fablackner/keysatron/assembly/keysatron_bom.csv

Comment | Designator | Footprint | LCSC
100n | C1 | Capacitor_SMD:C_0603_1608Metric | C14663
2u2 | C11,C12 | Capacitor_SMD:C_0603_1608Metric | C23630
12p | C13,C14 | Capacitor_SMD:C_0402_1005Metric | C1547
4u7 | C2 | Capacitor_SMD:C_1206_3216Metric | C29823
33p | C3 | Capacitor_SMD:C_0603_1608Metric | C1663
10u | C4 | Capacitor_SMD:C_1206_3216Metric | C13585
4u7 | C5 | Capacitor_SMD:C_0603_1608Metric | C19666
100n | C6,C7,C8,C9,C10 | Capacitor_SMD:C_0402_1005Metric | C1525
RED | D1 | Diode_SMD:D_0603_1608Metric | C2286
B5819W | D2 | Diode_SMD:D_SOD-123 | C8598
GREEN | D3 | Diode_SMD:D_0603_1608Metric | C72043
SWD | J1 | Connector_PinHeader_2.54mm:PinHeader_1x05_P2.54mm_Vertical
USB | J2,J3 | Connector_USB:USB_A_Molex_67643_Horizontal
2.2u | L1 | Inductor_SMD:L_Sunlord_MWSA0518_5.4x5.2mm | C408408
100k | R1 | Resistor_SMD:R_0603_1608Metric | C25803
120k | R2 | Resistor_SMD:R_0603_1608Metric | C25808
68k | R3 | Resistor_SMD:R_0603_1608Metric | C23231
39k | R4 | Resistor_SMD:R_0603_1608Metric | C23153
1k | R5,R6 | Resistor_SMD:R_0603_1608Metric | C21190
47 | R7 | Resistor_SMD:R_0402_1005Metric | C25118
MP2451DT-LF-Z | U1 | Package_TO_SOT_SMD:SOT-23-6 | C14123
SRV05-4 | U2 | Package_TO_SOT_SMD:SOT-23-6 | C85364
STM32F405RGT6 | U3 | Package_QFP:LQFP-64_10x10mm_P0.5mm | C15742
16Mhz | Y1 | Crystal:Crystal_SMD_3225-4Pin_3.2x2.5mm | C13738
