fablackner/keysatron/keysatron.kicad_pcb

## KiCad design keysatron.kicad_pcb (2026-10-28)

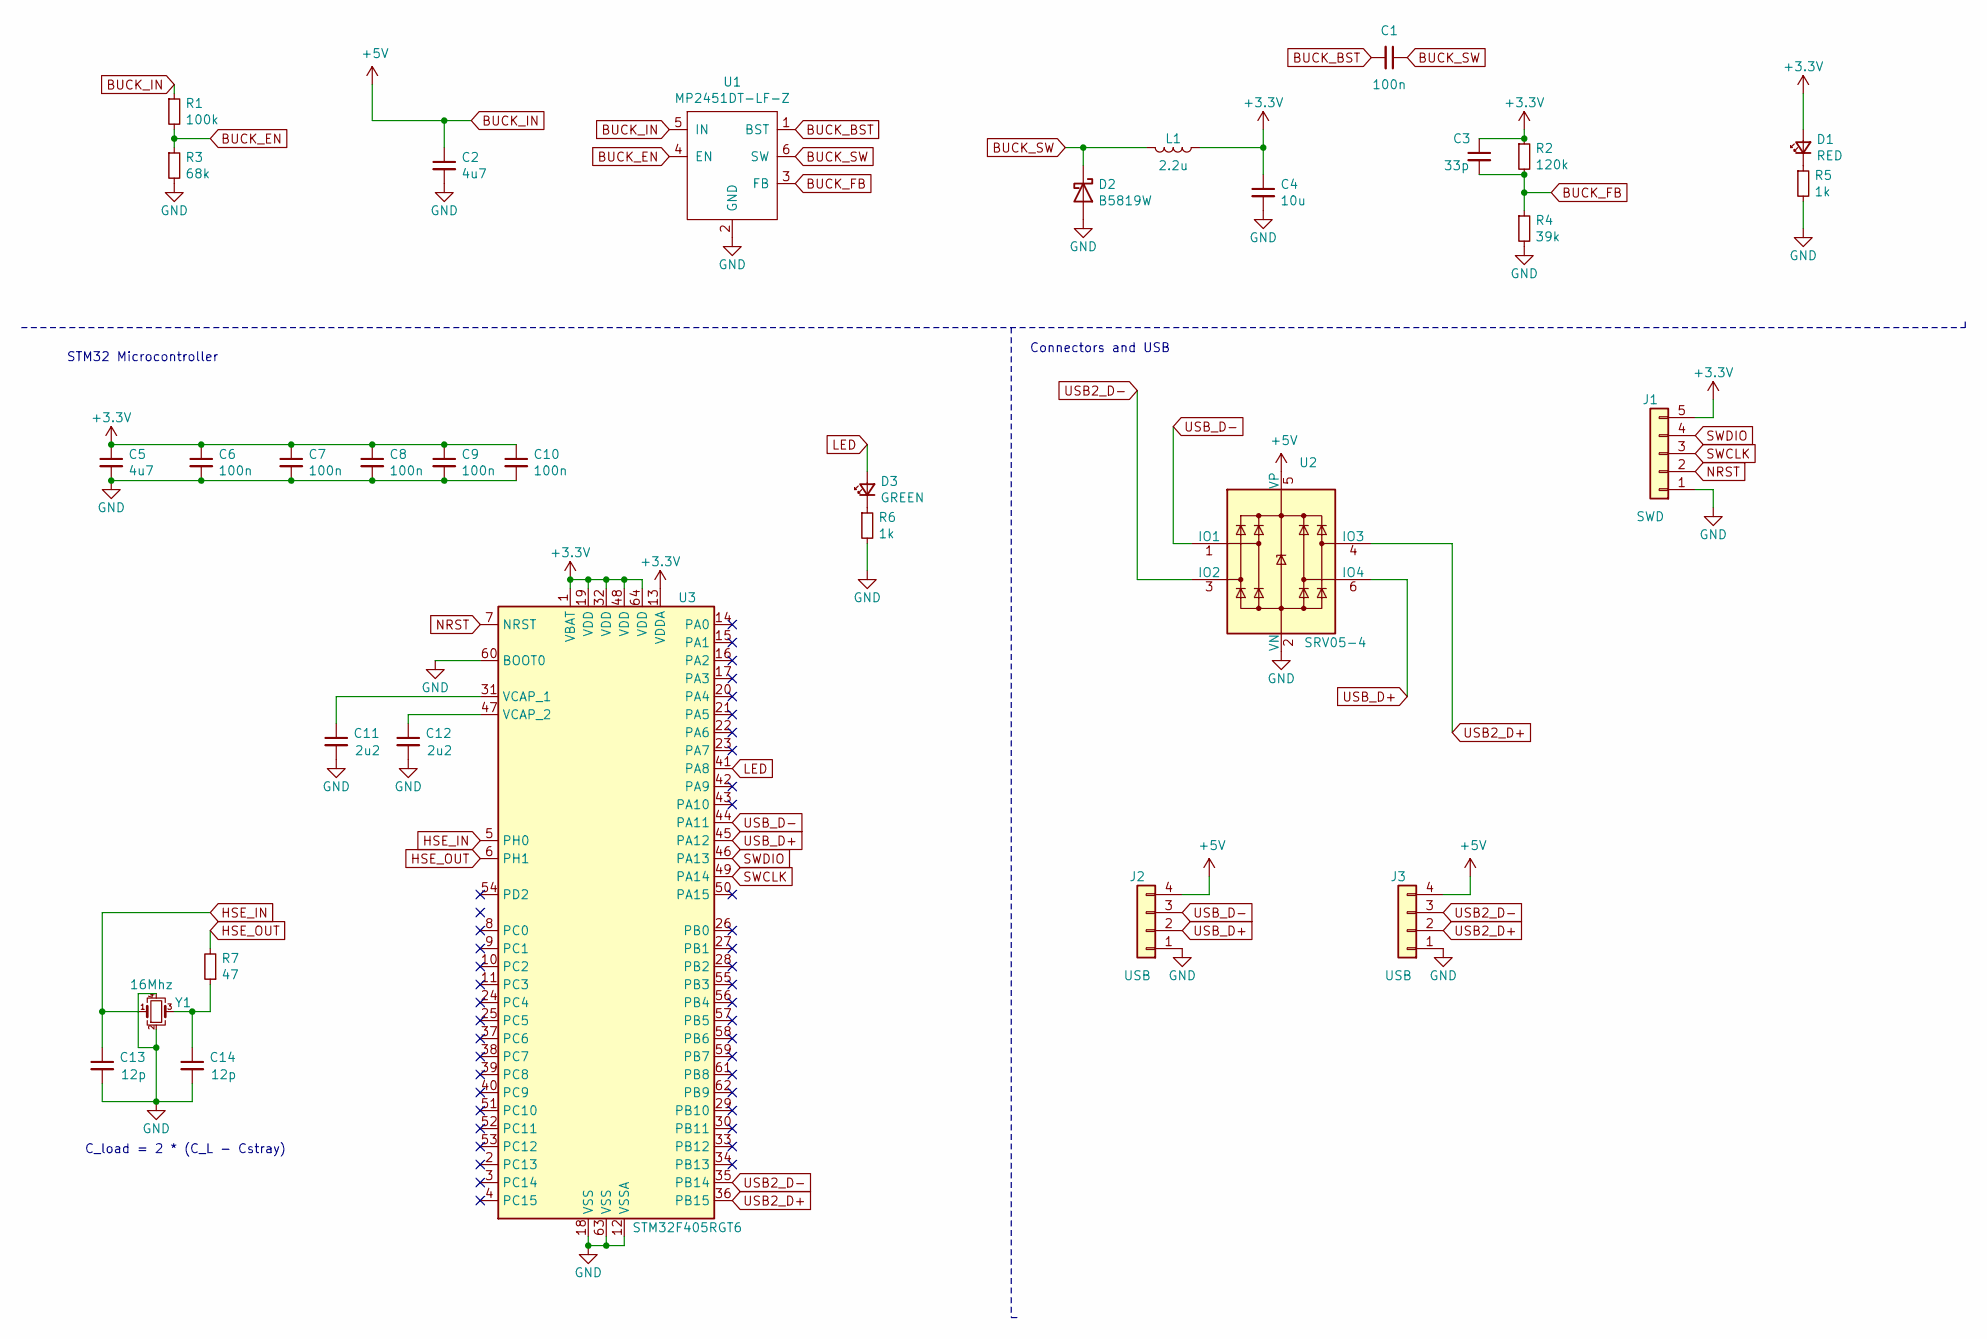
[picture p1: schematic keysatron.sch]

Parts:
C1: 100n; C_0603_1608Metric
C2: 4u7; C_1206_3216Metric
C3: 33p; C_0603_1608Metric
C4: 10u; C_1206_3216Metric
C5: 4u7; C_0603_1608Metric
C6, C7, C8, C9, C10: 100n; C_0402_1005Metric
C11, C12: 2u2; C_0603_1608Metric
C13, C14: 12p; C_0402_1005Metric
D1: RED; D_0603_1608Metric
D2: B5819W; D_SOD-123
D3: GREEN; D_0603_1608Metric
J1: SWD; PinHeader_1x05_P2.54mm_Vertical
J2, J3: USB; USB_A_Molex_67643_Horizontal
L1: 2.2u; L_Sunlord_MWSA0518_5.4x5.2mm
R1: 100k; R_0603_1608Metric
R2: 120k; R_0603_1608Metric
R3: 68k; R_0603_1608Metric
R4: 39k; R_0603_1608Metric
R5, R6: 1k; R_0603_1608Metric
R7: 47; R_0402_1005Metric
U1: MP2451DT-LF-Z; SOT-23-6
U2: SRV05-4; SOT-23-6
U3: STM32F405RGT6; LQFP-64_10x10mm_P0.5mm
Y1: 16Mhz; Crystal_SMD_3225-4Pin_3.2x2.5mm

Connections:
+3V3: C3.1, C4.1, C5.1, C6.1, C7.1, C8.1, C9.1, C10.1, D1.2 (A), J1.5, L1.1, R2.1, U3.1 (VBAT), U3.13 (VDDA), U3.19 (VDD), U3.32 (VDD), U3.48 (VDD), U3.64 (VDD)
BUCK_BST: C1.2, U1.1 (BST)
BUCK_EN: R1.2, R3.1, U1.4 (EN)
BUCK_FB: C3.2, R2.2, R4.1, U1.3 (FB)
BUCK_IN: C2.1, J2.4, J3.4, R1.1, U1.5 (IN), U2.5 (VP)
BUCK_SW: C1.1, D2.1 (K), L1.2, U1.6 (SW)
GND: C2.2, C4.2, C5.2, C6.2, C7.2, C8.2, C9.2, C10.2, C11.2, C12.2, C13.2, C14.2, D2.2 (A), J1.1, J2.1, J3.1, R3.2, R4.2, R5.2, R6.2, U1.2 (GND), U2.2 (VN), U3.12 (VSSA), U3.18 (VSS), U3.60 (BOOT0), U3.63 (VSS), Y1.2, Y1.4
HSE_IN: C13.1, U3.5 (PH0), Y1.1
HSE_OUT: R7.2, U3.6 (PH1)
LED: D3.2 (A), U3.41 (PA8)
NRST: J1.2, U3.7 (NRST)
unnamed: C11.1, U3.31 (VCAP_1)
unnamed: C12.1, U3.47 (VCAP_2)
unnamed: C14.1, R7.1, Y1.3
unnamed: D1.1 (K), R5.1
unnamed: D3.1 (K), R6.1
SWCLK: J1.3, U3.49 (PA14)
SWDIO: J1.4, U3.46 (PA13)
USB2_D+: J3.2, U2.4 (IO3), U3.36 (PB15)
USB2_D-: J3.3, U2.3 (IO2), U3.35 (PB14)
USB_D+: J2.2, U2.6 (IO4), U3.45 (PA12)
USB_D-: J2.3, U2.1 (IO1), U3.44 (PA11)

Notes on the sheet:
C_load = 2 * (C_L - Cstray)
STM32 Microcontroller
Connectors and USB

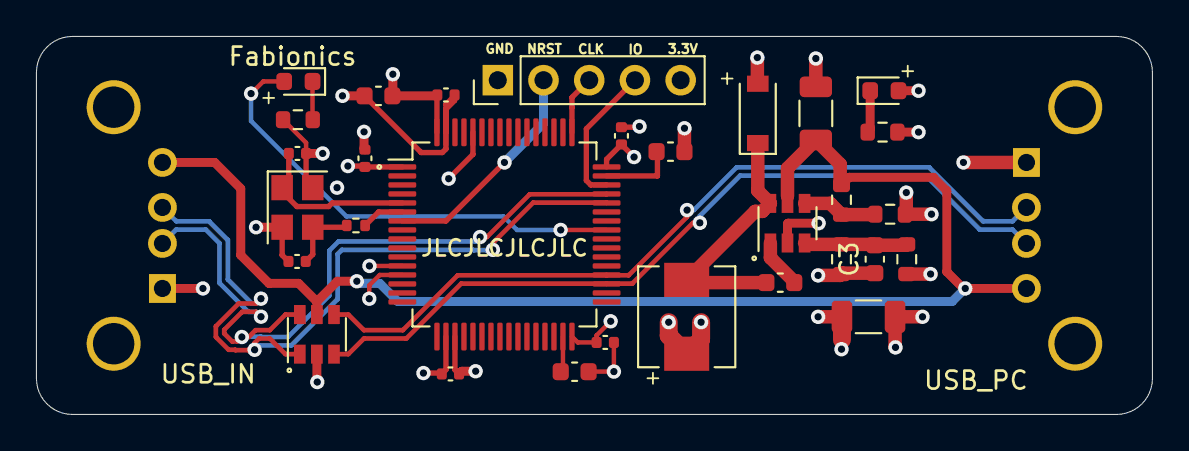
[picture p2: board keysatron.kicad_pcb from above]

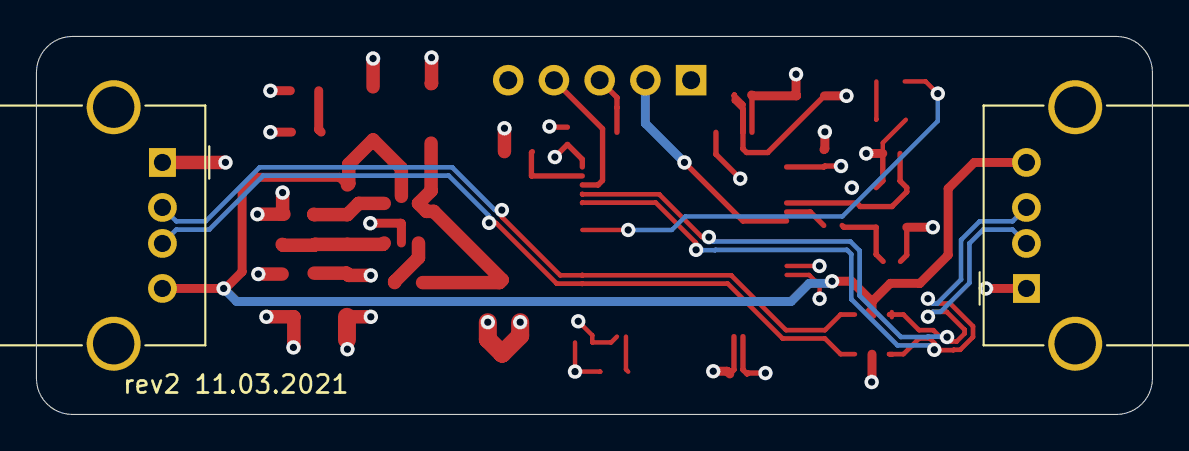
[picture p3: board keysatron.kicad_pcb from below]

Board: 4 copper layers, 62.0 x 21.0 mm, 32 parts (2 on the bottom side), 22 nets.
