fablackner/keysatron/(commit log)

2026-10-28 Initial commit of Keysatron hardware PCB design
    [stm32UsbInOut-B_Cu.gbr, stm32UsbInOut-B_Mask.gbr, stm32UsbInOut-B_Paste.gbr, stm32UsbInOut-B_SilkS.gbr, stm32UsbInOut-Edge_Cuts.gbr, stm32UsbInOut-F_Cu.gbr, stm32UsbInOut-F_Mask.gbr, stm32UsbInOut-F_Paste.gbr]
2026-10-28 Rename project files to match keysatron naming scheme
    [keysatron-B_Cu.gbr, keysatron-B_Mask.gbr, keysatron-B_Paste.gbr, keysatron-B_SilkS.gbr, keysatron-Edge_Cuts.gbr, keysatron-F_Cu.gbr, keysatron-F_Mask.gbr, keysatron-F_Paste.gbr]
